vinaebizs/fs-bb48/output/fs-bb48-back.png

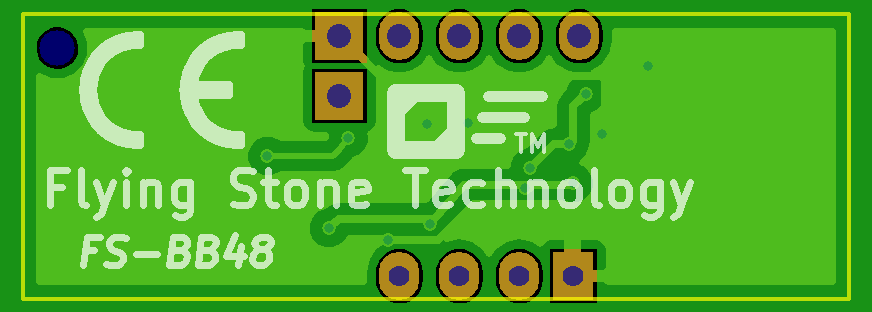
output/fs-bb48-back.png
