vinaebizs/fs-bb48/output/fs-bb48-conn.png

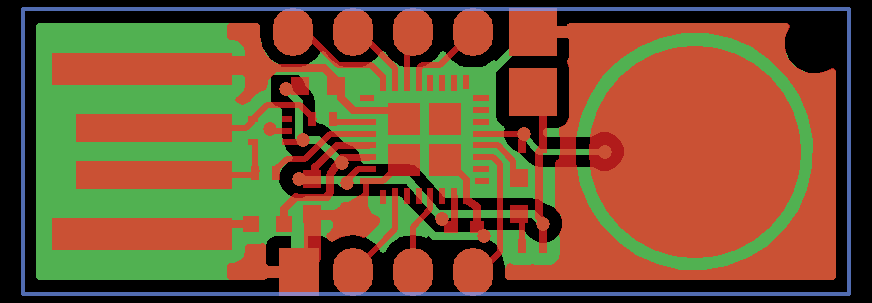
output/fs-bb48-conn.png
