vinaebizs/fs-bb48/output/fs-bb48-front.png

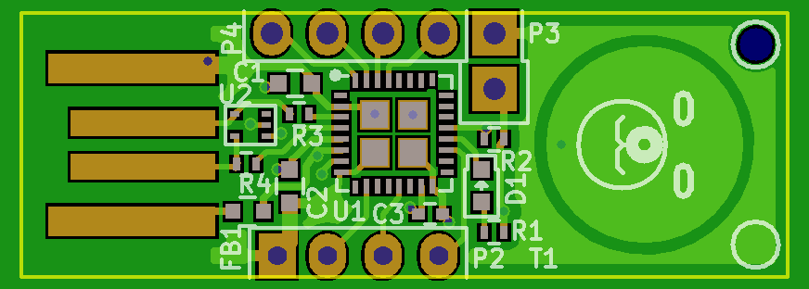
output/fs-bb48-front.png
