vinaebizs/fs-bb48/output/fs-bb48.pdf

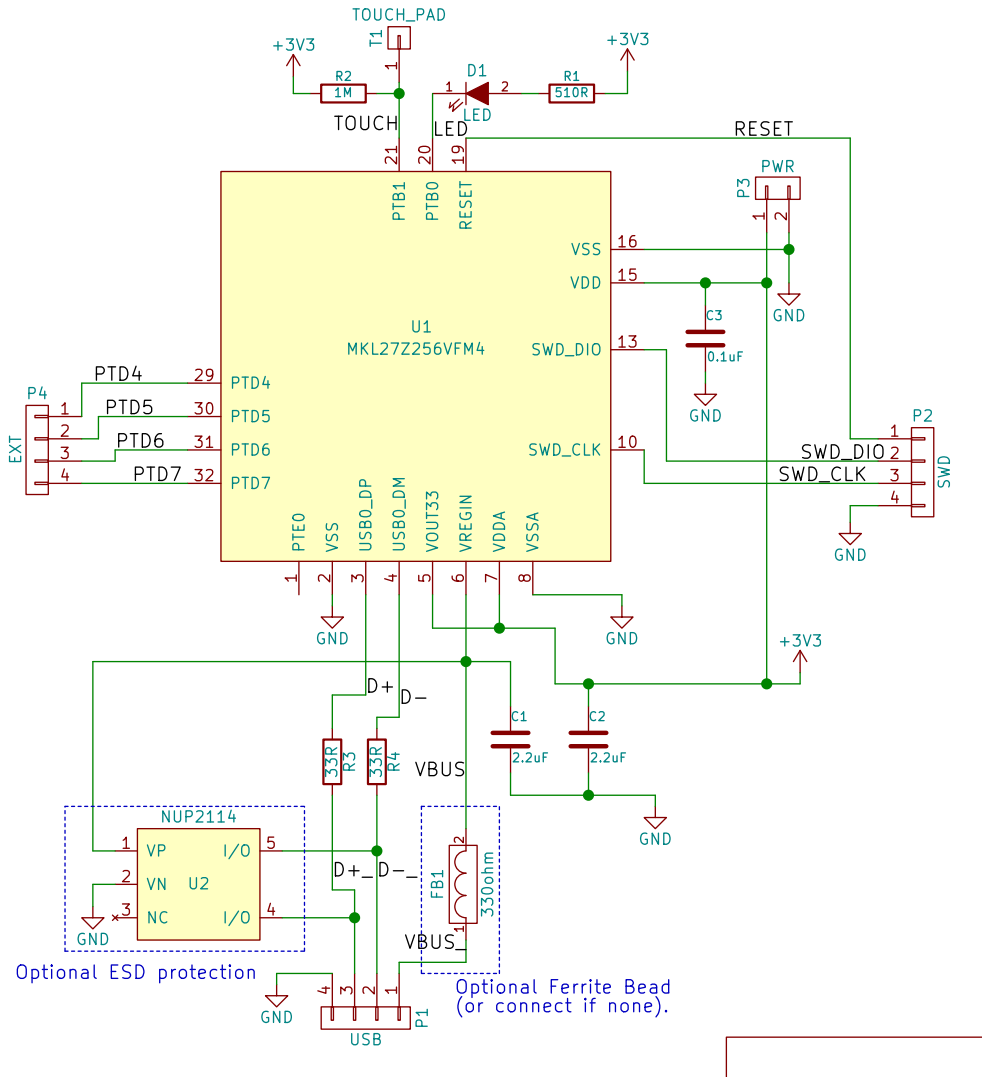
[picture p4: page 1]

(or connect if none).
