vinaebizs/fs-bb48/fs-bb48.kicad_pcb

## KiCad design fs-bb48.kicad_pcb (2016-07-04)

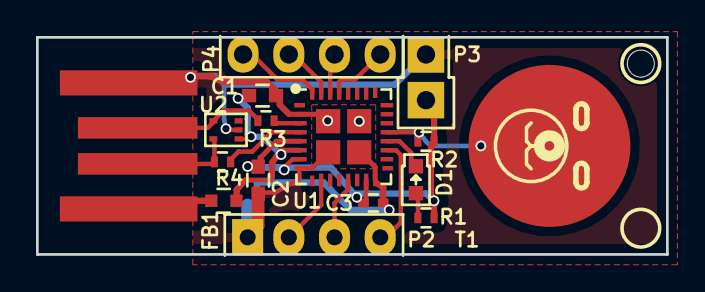
[picture p5: board fs-bb48.kicad_pcb from above]

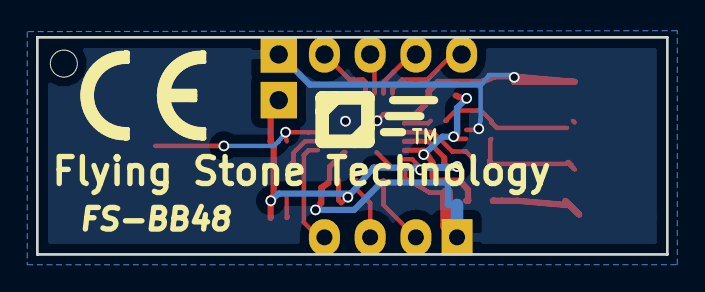
[picture p6: board fs-bb48.kicad_pcb from below]

Board: 2 copper layers, 35.0 x 12.1 mm, 19 parts (2 on the bottom side), 18 nets.

Parts:
C1, C2: 2.2uF; C_0603
C3: 0.1uF; C_0402
CE1: CE_5mm; Symbol_CE_SilkScreen_5mm
D1: LED; LED-0603
FB1: 330ohm; FB_SM0603
FST-LOGO: LOGO1; FST-LOGO
H1: Hole
P1: USB; usb-PCB
P2: SWD; Pin_Header_Straight_1x04_A
P3: PWR; Pin_Header_Straight_1x02
P4: EXT; Pin_Header_Straight_1x04
R1: 510R; R_0402
R2: 1M; R_0402
R3, R4: 33R; R_0402
T1: TOUCH_PAD; TOUCH_PAD_9mm
U1: MKL27Z256VFM4; QFN-32-1EP_5x5mm_Pitch0.5mm
U2: NUP2114; SOT-553

Connections:
+3V3: C2.1, C3.1, P3.1, R1.2, R2.1, U1.5, U1.7, U1.15
/D+: R3.1, U1.3
/D+_: P1.3, R3.2, U2.4
/D-: R4.1, U1.4
/D-_: P1.2, R4.2, U2.5
/LED: D1.1, U1.20
/PTD4: P4.1, U1.29
/PTD5: P4.2, U1.30
/PTD6: P4.3, U1.31
/PTD7: P4.4, U1.32
/RESET: P2.1, U1.19
/SWD_CLK: P2.3, U1.10
/SWD_DIO: P2.2, U1.13
/TOUCH: R2.2, T1.1, U1.21
/VBUS: C1.1, FB1.2, U1.6, U2.1
/VBUS_: FB1.1, P1.1
GND: C1.2, C2.2, C3.2, P1.4, P2.4, P3.2, U1.2, U1.8, U1.16, U2.2
unnamed: D1.2, R1.1
