vinaebizs/fs-bb48/(commit log)

2016-01-13 start KiCAD project
2016-01-13 Add schematic.
    [fs-bb48.sch]
2016-01-13 Add the .kicad_pcb file
    [fs-bb48.kicad_pcb]
2016-01-14 update schematic
    [fs-bb48.kicad_pcb, fs-bb48.sch]
2016-01-14 add footprints
    [fs-bb48.kicad_pcb, fs-bb48.sch]
2016-01-15 more update
    [fs-bb48.kicad_pcb]
2016-01-15 fix hole size
    [fs-bb48.kicad_pcb]
2016-01-15 solder mask fingerprints change
    [fs-bb48.kicad_pcb]
2016-01-15 Add a script to order fusion PCB
2016-01-15 update dimensions for pcbnew
2016-01-15 Move silks of U1 and U2
    [fs-bb48.kicad_pcb]
2016-01-16 add bare bone animal
    [fs-bb48.kicad_pcb]
2016-01-16 finish BBB
    [fs-bb48.kicad_pcb]
2016-01-16 Added CE marking
    [fs-bb48-B_Cu.gbr, fs-bb48-B_Mask.gbr, fs-bb48-B_Paste.gbr, fs-bb48-B_SilkS.gbr, fs-bb48-Edge_Cuts.gbr, fs-bb48-F_Cu.gbr, fs-bb48-F_Mask.gbr, fs-bb48-F_Paste.gbr]
2016-01-18 move silks
    [fs-bb48.kicad_pcb]
2016-01-19 Change U2 and make it optional
    [fs-bb48.sch]
2016-01-20 Make optional ESD/EMI explicit
    [fs-bb48.sch]
2016-01-20 finish change of ESD chip
    [fs-bb48.kicad_pcb, fs-bb48.sch]
2016-01-20 each chip is optional
    [fs-bb48.sch]
2016-01-20 Remove C3, fix FB1, add hole, fix solder paste of U1
    [fs-bb48.kicad_pcb, fs-bb48.sch]
2016-01-20 modify VBUS line
    [fs-bb48.kicad_pcb]
2016-01-20 fix GND line
    [fs-bb48.kicad_pcb]
2016-01-21 Fix U1 pads
    [fs-bb48.kicad_pcb]
2016-01-21 Move R4 reference
    [fs-bb48.kicad_pcb]
2016-02-26 tweak USB-A footprint and bear
    [fs-bb48.kicad_pcb]
2016-03-04 update modules and pcb design
    [fs-bb48.kicad_pcb]
2016-03-04 USB PCB connector footprint modification
    [fs-bb48.kicad_pcb]
2016-07-01 Change USB connector pattern, move CE mark, extend copper backside, tweak a via
    [fs-bb48.kicad_pcb]
2016-07-04 Fix file extentions for newer KiCAD
    [fs-bb48.kicad_pcb]
2016-07-05 Add schematic PDF and BOM-csv for PCBA.
    [bom-fs-bb48.csv]
